syfluqs/farmbot/CAD/Render/stepper_motor_render.JPG

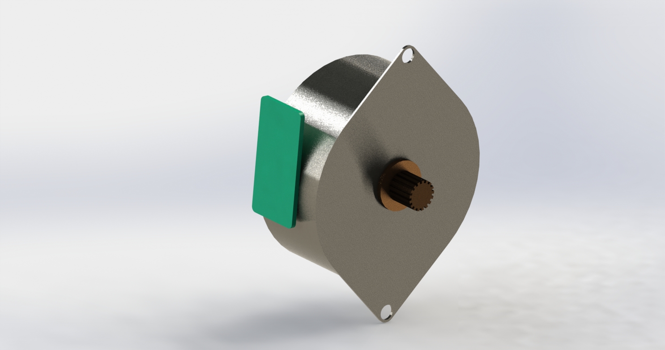
CAD/Render/stepper_motor_render.JPG
