syfluqs/farmbot/CAD/Render/carriage_motor_render_2.JPG

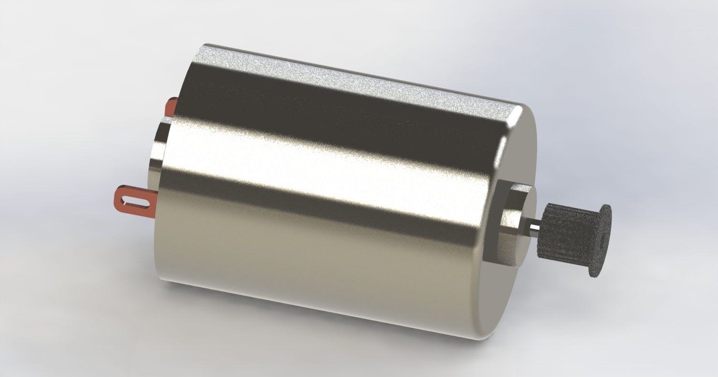
CAD/Render/carriage_motor_render_2.JPG
