syfluqs/farmbot/README.md

# farmbot
Firmware and code for 5th semester minor project

CAD model
<div class="sketchfab-embed-wrapper"><iframe width="640" height="480" src="https://sketchfab.com/models/de0491b01be34c9b8ab4bd9d8cf1a044/embed" frameborder="0" allowvr allowfullscreen mozallowfullscreen="true" webkitallowfullscreen="true" onmousewheel=""></iframe>

<p style="font-size: 13px; font-weight: normal; margin: 5px; color: #4A4A4A;">
    <a href="https://sketchfab.com/models/de0491b01be34c9b8ab4bd9d8cf1a044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" target="_blank" style="font-weight: bold; color: #1CAAD9;">Farmbot</a>
    by <a href="https://sketchfab.com/syfluqs?utm_medium=embed&utm_source=website&utm_campain=share-popup" target="_blank" style="font-weight: bold; color: #1CAAD9;">Subham Roy</a>
    on <a href="https://sketchfab.com?utm_medium=embed&utm_source=website&utm_campain=share-popup" target="_blank" style="font-weight: bold; color: #1CAAD9;">Sketchfab</a>
</p>
</div>

View the CAD model at http://sketchfab.com/models/de0491b01be34c9b8ab4bd9d8cf1a044 and components at https://grabcad.com/library/farmbot-1
