syfluqs/farmbot/CAD/Render/carriage_motor_render.JPG

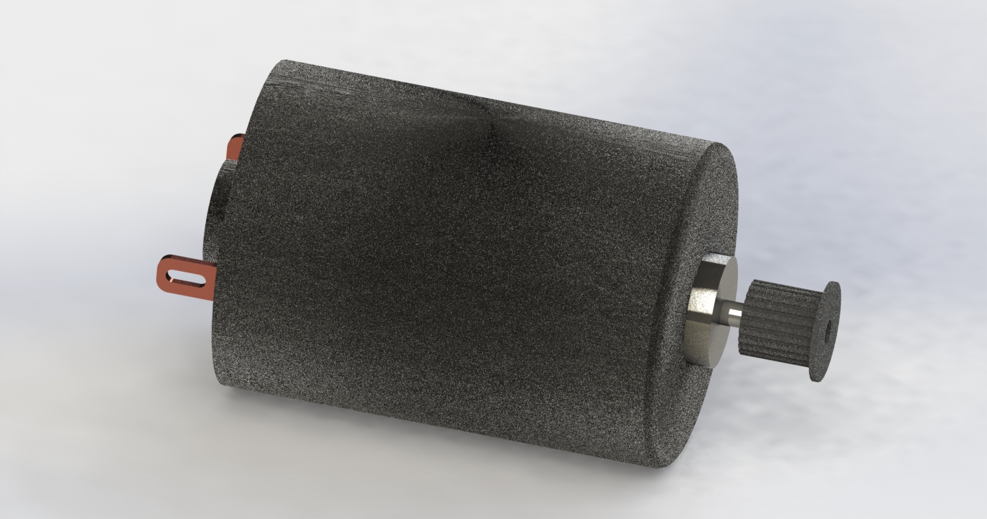
CAD/Render/carriage_motor_render.JPG
