syfluqs/farmbot/CAD/Render/johnson_motor_render.JPG

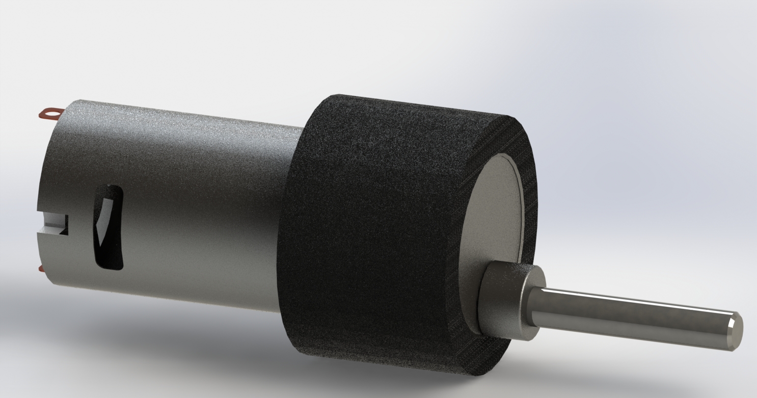
CAD/Render/johnson_motor_render.JPG
