syfluqs/farmbot/CAD/Render/rack_pinion_render_1.JPG

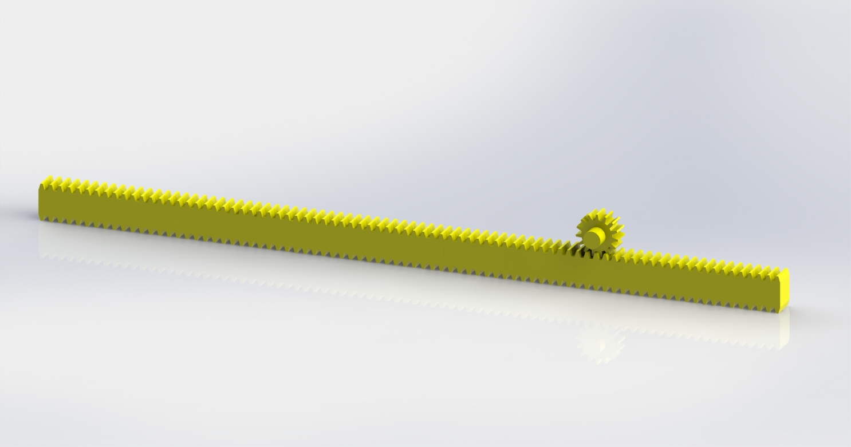
CAD/Render/rack_pinion_render_1.JPG
