syfluqs/farmbot/CAD/Render/rack_pinion_render_2.JPG

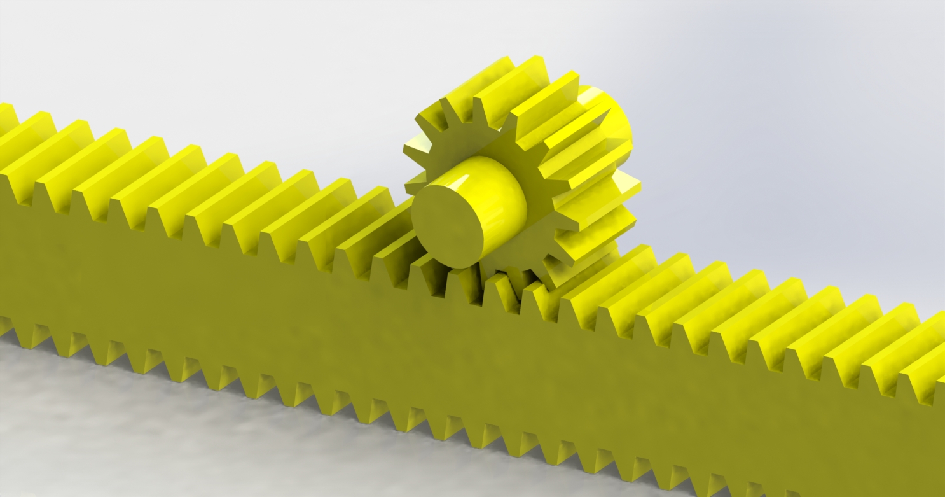
CAD/Render/rack_pinion_render_2.JPG
