syfluqs/farmbot/CAD/Render/rack_pinion_render_3.JPG

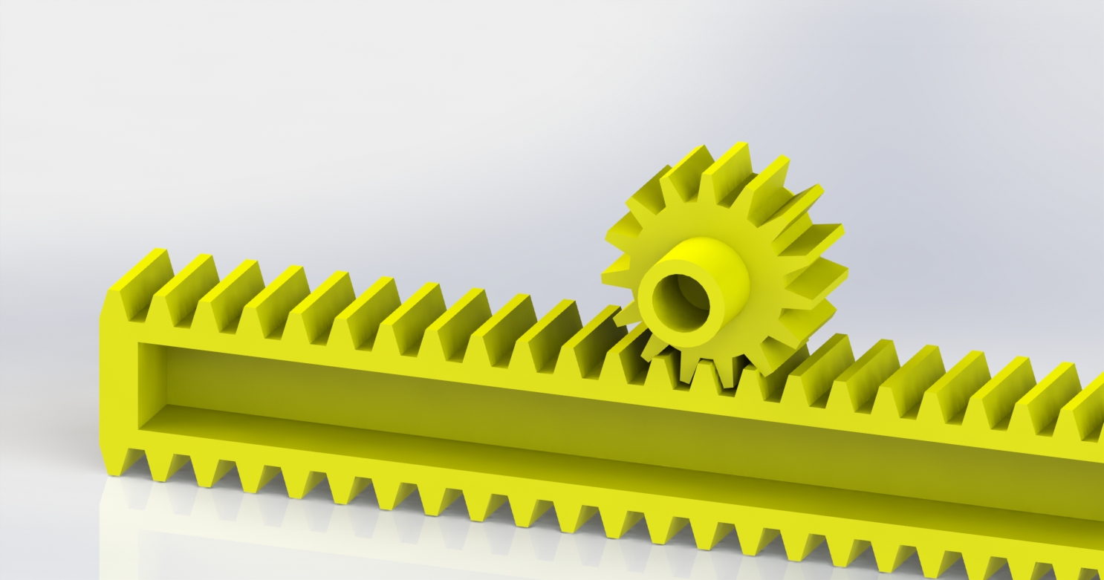
CAD/Render/rack_pinion_render_3.JPG
