syfluqs/farmbot/CAD/Render/wheel_rail_render.JPG

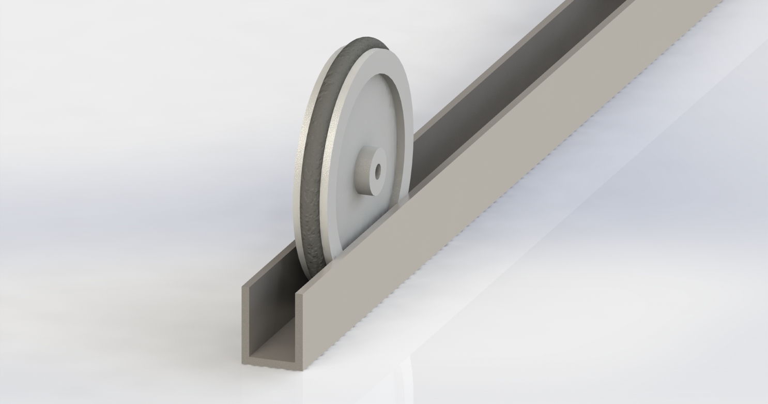
CAD/Render/wheel_rail_render.JPG
