syfluqs/farmbot/Circuit Diagram/Circuit_Diagram.png

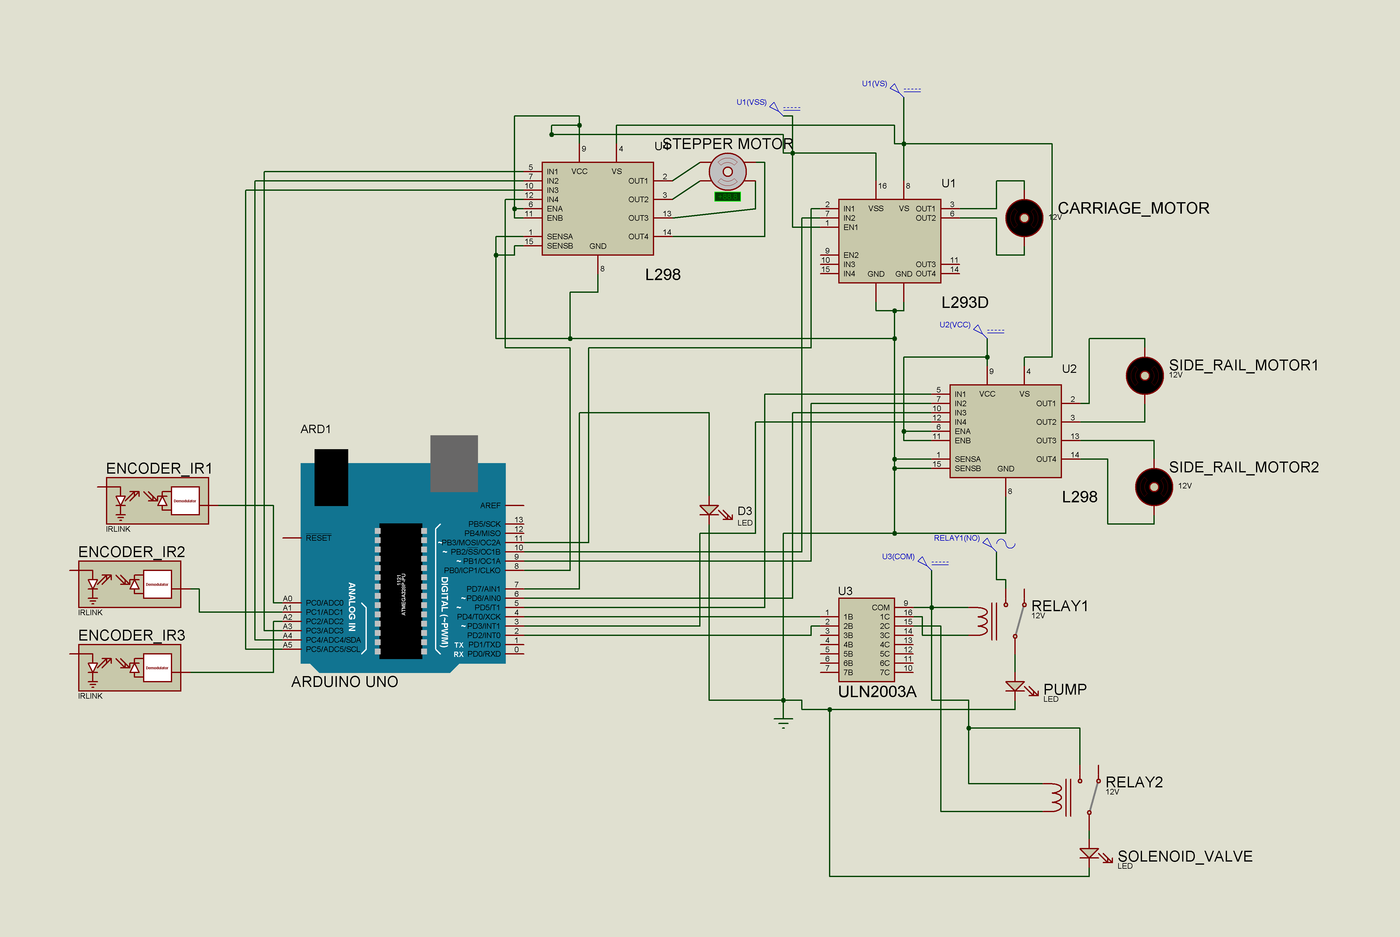
Circuit Diagram/Circuit_Diagram.png
