syfluqs/farmbot/CAD/final_assembly.SLDASM

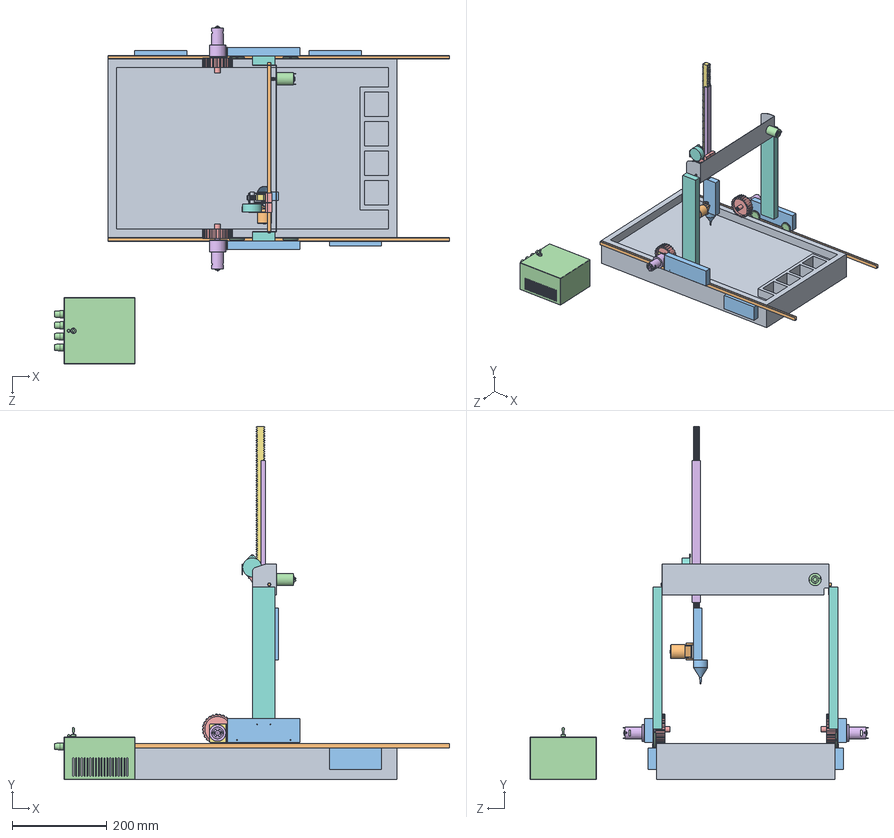
[picture p57: CAD file, 2016-11-20]
CAD/final_assembly.SLDASM
832.9 x 744.9 x 712.8 mm
soil_bed
rail x 2
connecting_plank x 2
pulley_wheel x 4
wheel_small x 2
motor_johnson x 2
clamp x 2
gantry_plank x 2
printer_bed_walls
lead_rod
supporting_block x 4
carriage_motor
printer_carriage
casing
rack
stepper
pinion
solenoid_valve
nozzle
psu
