syfluqs/farmbot/CAD/rack_pinion_assembly.SLDASM

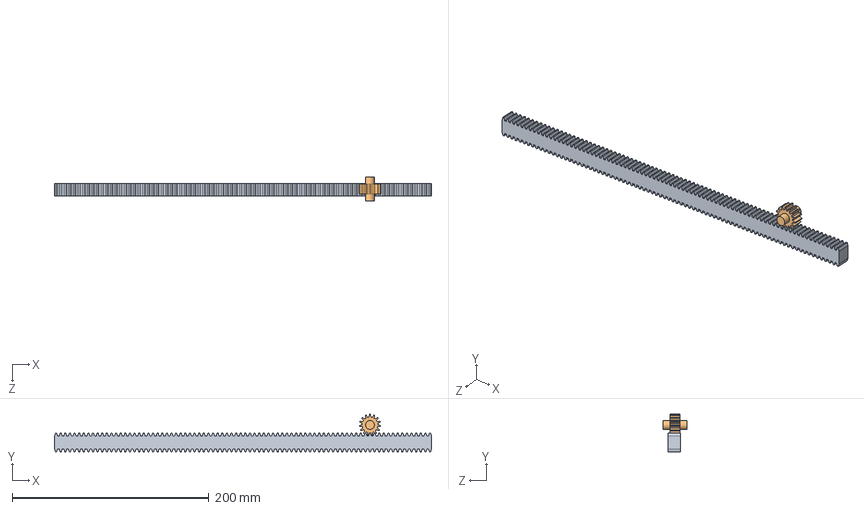
[picture p58: CAD file, 2016-11-20]
CAD/rack_pinion_assembly.SLDASM
383.0 x 38.2 x 24.0 mm
rack
pinion
