syfluqs/farmbot/CAD/Components/rail.SLDPRT

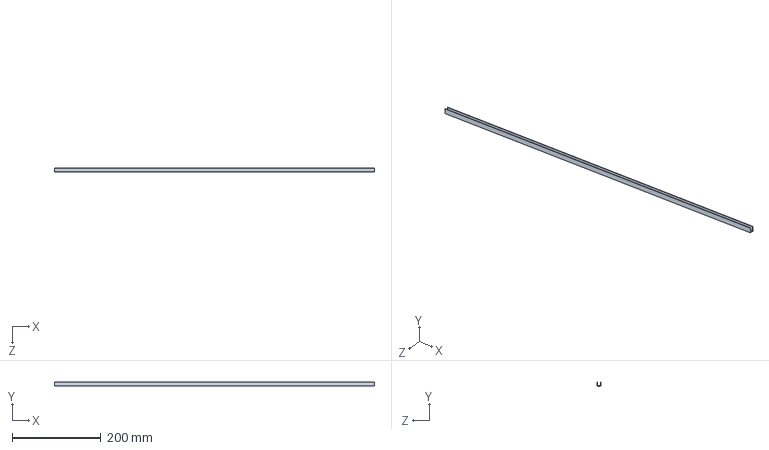
[picture p59: CAD file, 2016-11-20]
CAD/Components/rail.SLDPRT
720.0 x 10.0 x 8.00 mm
