syfluqs/farmbot/CAD/printer_carriage.SLDPRT

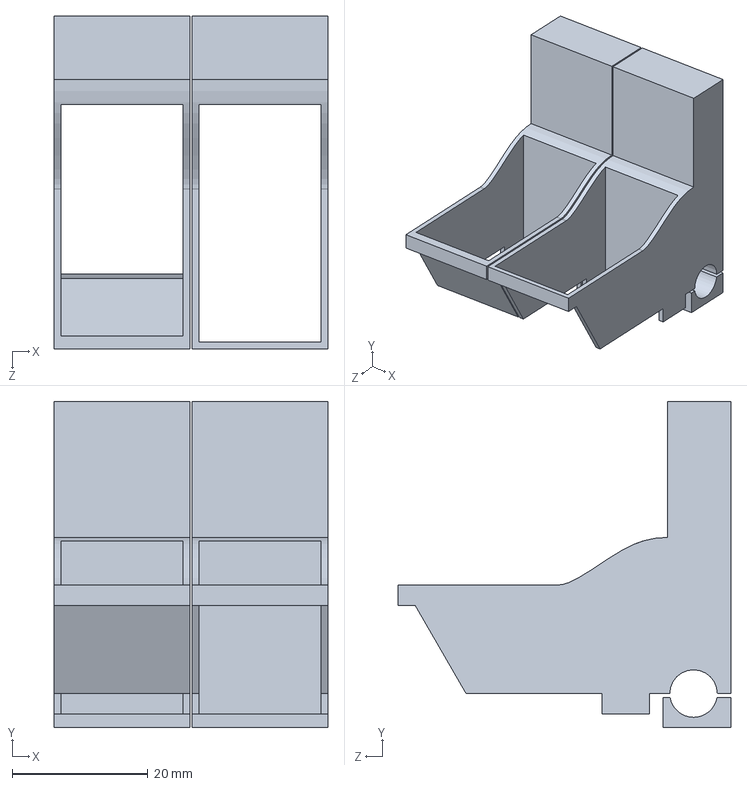
[picture p60: CAD file, 2016-11-20]
CAD/printer_carriage.SLDPRT
40.3 x 48.0 x 49.0 mm
