syfluqs/farmbot/CAD/Components/printer_bed_walls.SLDPRT

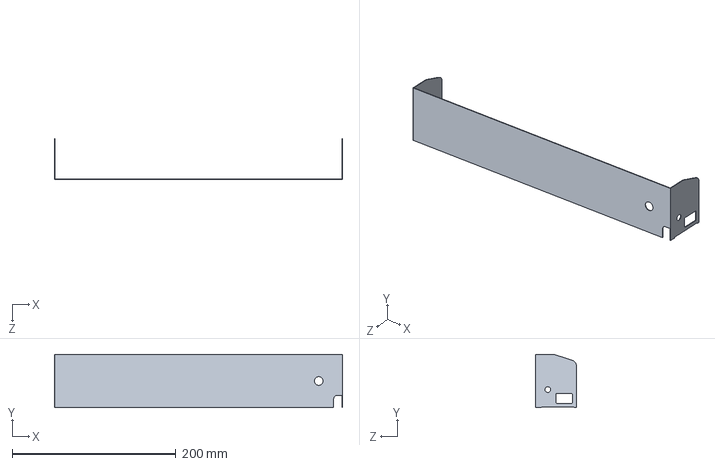
[picture p61: CAD file, 2016-11-18]
CAD/Components/printer_bed_walls.SLDPRT
351.4 x 65.0 x 50.0 mm
