syfluqs/farmbot/CAD/soil_bed.SLDPRT

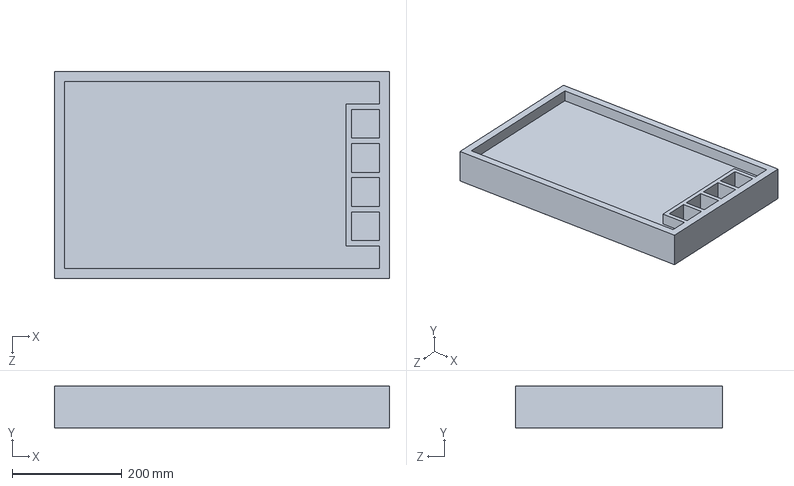
[picture p62: CAD file, 2016-11-20]
CAD/soil_bed.SLDPRT
609.6 x 76.2 x 376.4 mm
