syfluqs/farmbot/CAD/Components/gantry_plank.SLDPRT

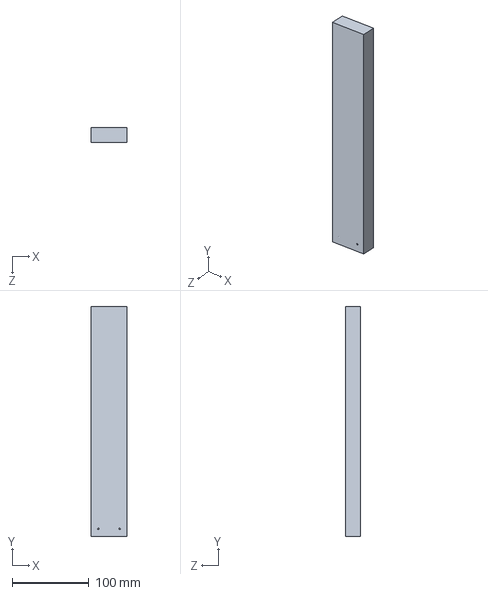
[picture p63: CAD file, 2016-11-18]
CAD/Components/gantry_plank.SLDPRT
47.0 x 300.0 x 19.0 mm
