syfluqs/farmbot/CAD/nozzle.SLDPRT

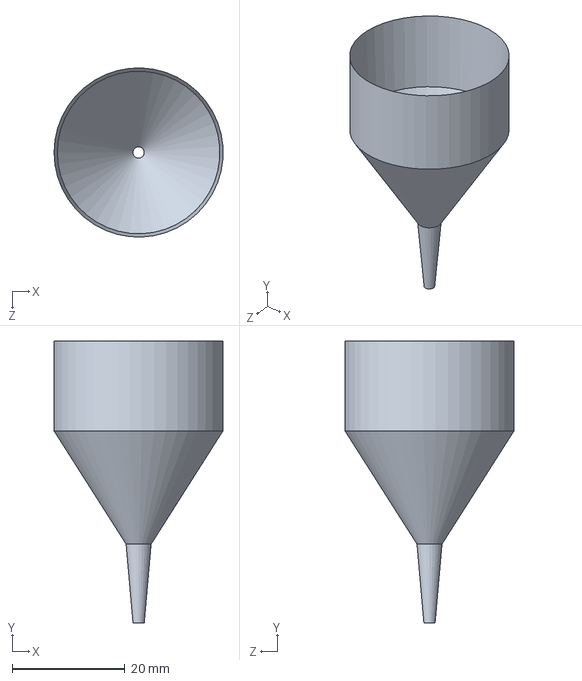
[picture p64: CAD file, 2016-11-20]
CAD/nozzle.SLDPRT
30.0 x 50.0 x 30.0 mm
