syfluqs/farmbot/CAD/casing.SLDPRT

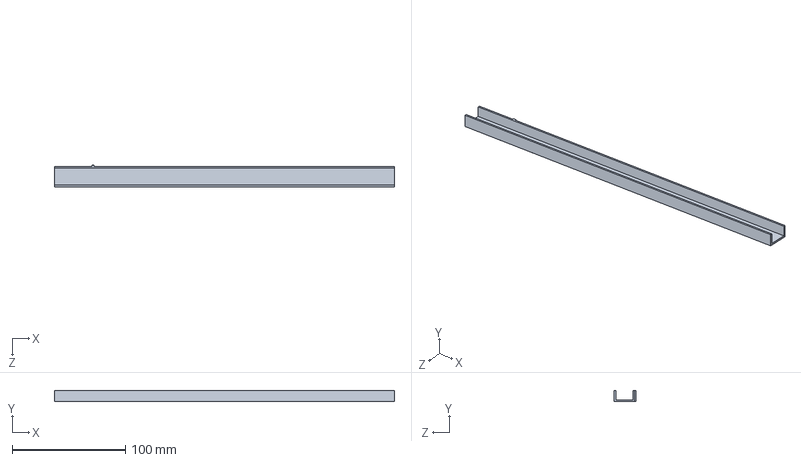
[picture p65: CAD file, 2016-11-20]
CAD/casing.SLDPRT
300.0 x 10.0 x 19.0 mm
