syfluqs/farmbot/CAD/Components/lead_rod.SLDPRT

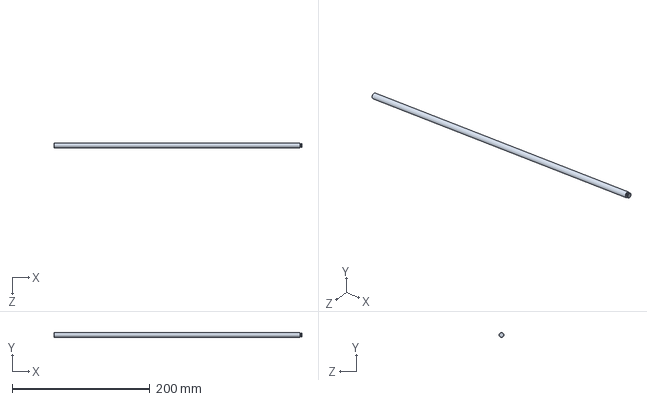
[picture p66: CAD file, 2016-11-15]
CAD/Components/lead_rod.SLDPRT
360.0 x 7.00 x 7.00 mm
