syfluqs/farmbot/CAD/wheel_small.SLDPRT

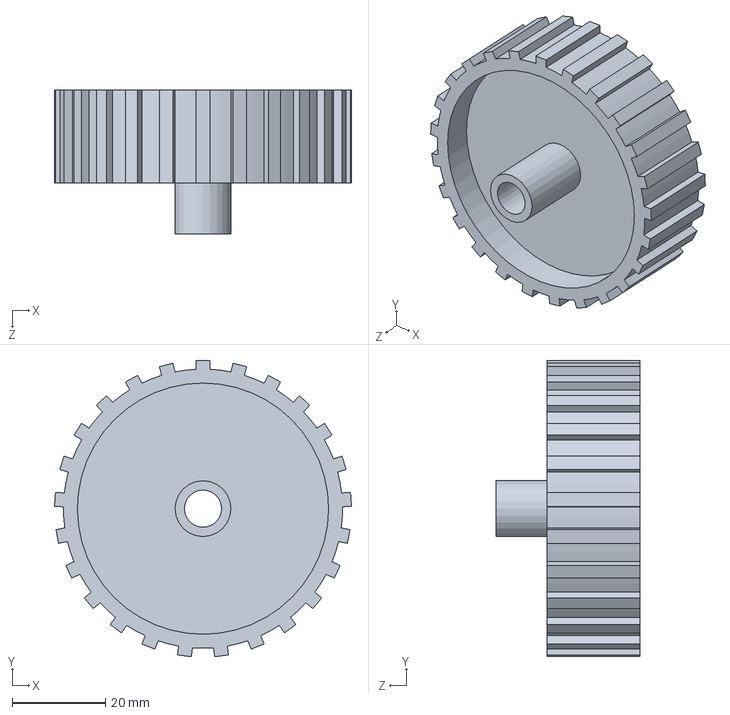
[picture p67: CAD file, 2016-11-20]
CAD/wheel_small.SLDPRT
63.8 x 63.7 x 31.0 mm
