syfluqs/farmbot/CAD/connecting_plank.SLDPRT

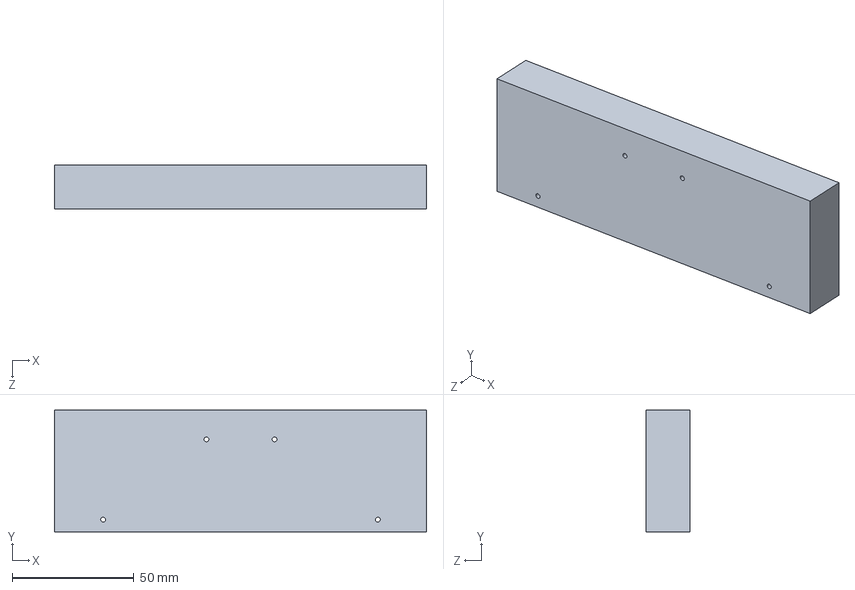
[picture p68: CAD file, 2016-11-20]
CAD/connecting_plank.SLDPRT
153.0 x 50.0 x 18.0 mm
