syfluqs/farmbot/CAD/rack.SLDPRT

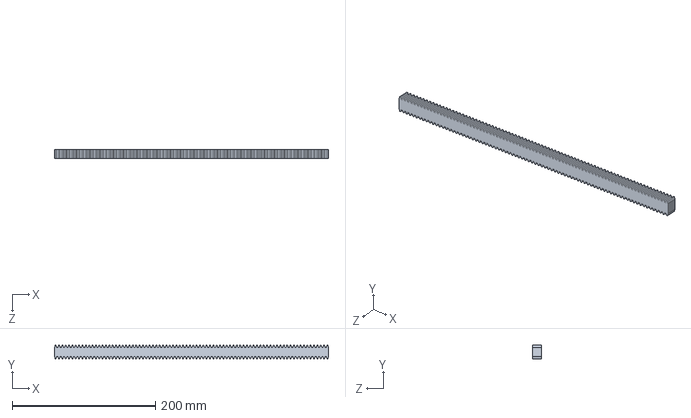
[picture p69: CAD file, 2016-11-20]
CAD/rack.SLDPRT
383.0 x 19.0 x 13.0 mm
