syfluqs/farmbot/CAD/pinion.SLDPRT

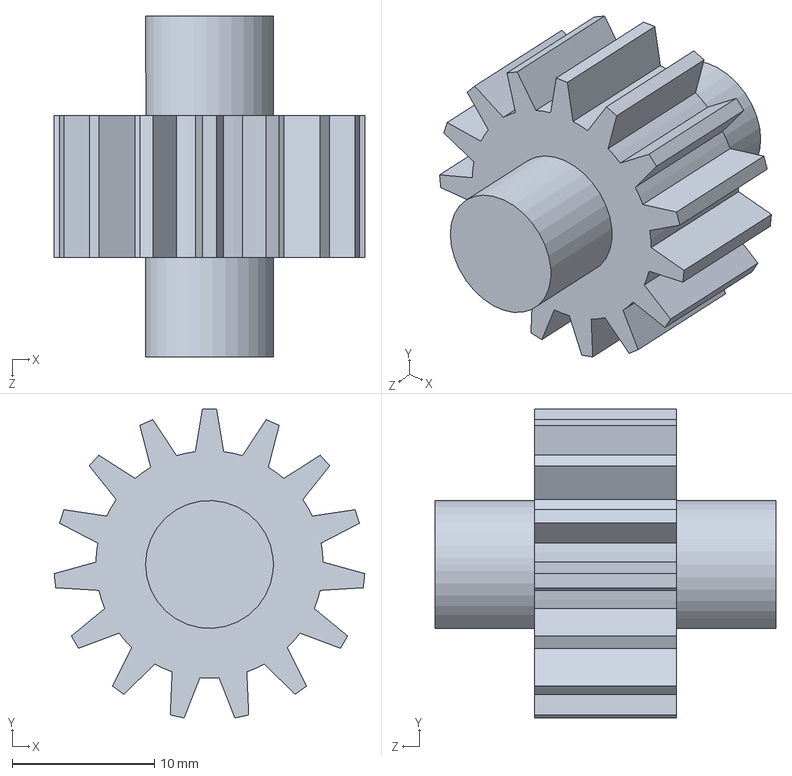
[picture p70: CAD file, 2016-11-20]
CAD/pinion.SLDPRT
21.9 x 21.7 x 24.0 mm
