syfluqs/farmbot/CAD/solenoid_valve.SLDPRT

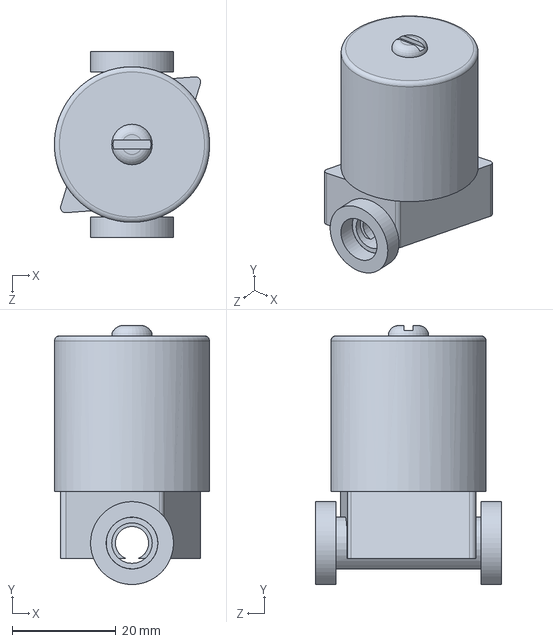
[picture p71: CAD file, 2016-11-20]
CAD/solenoid_valve.SLDPRT
30.0 x 50.0 x 36.0 mm
