syfluqs/farmbot/CAD/supporting_block.SLDPRT

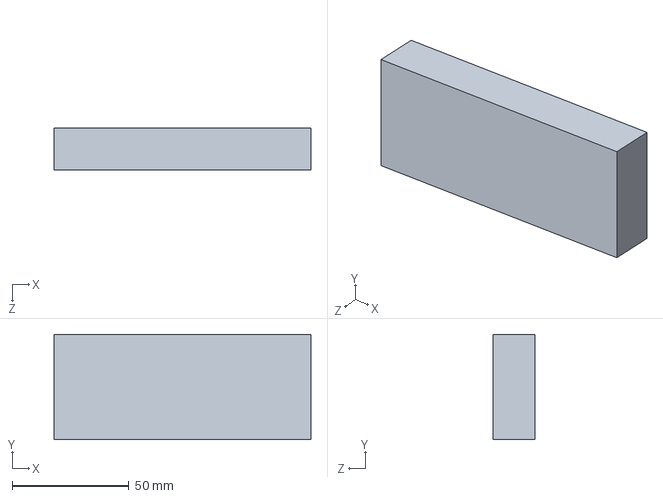
[picture p72: CAD file, 2016-11-20]
CAD/supporting_block.SLDPRT
110.0 x 45.0 x 18.0 mm
