syfluqs/farmbot/CAD/psu.SLDPRT

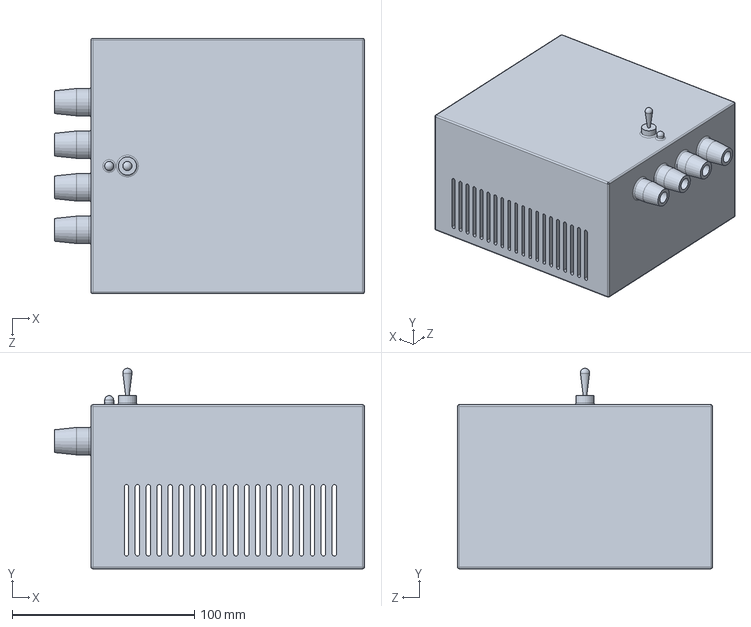
[picture p73: CAD file, 2016-11-20]
CAD/psu.SLDPRT
170.0 x 110.0 x 140.0 mm
