syfluqs/farmbot/CAD/arduino nano.SLDPRT

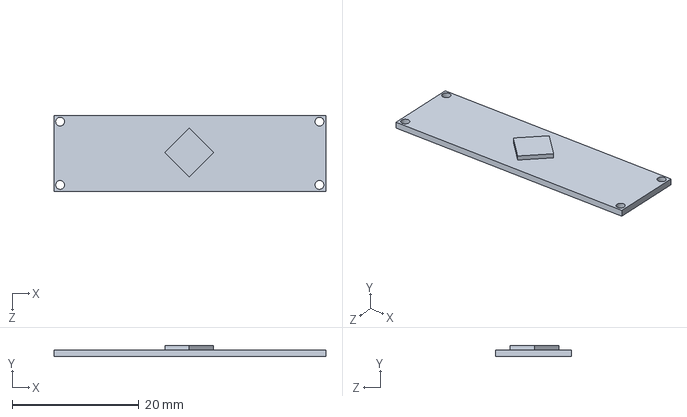
[picture p74: CAD file, 2016-11-18]
CAD/arduino nano.SLDPRT
43.0 x 1.70 x 12.0 mm
