syfluqs/farmbot/CAD/clamp.SLDPRT

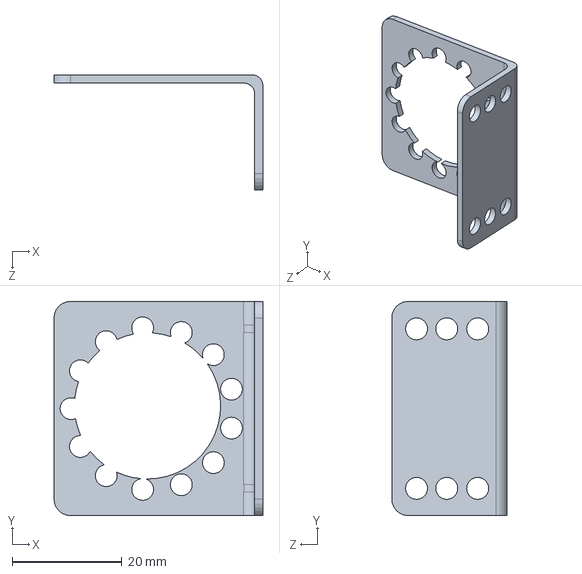
[picture p75: CAD file, 2016-11-18]
CAD/clamp.SLDPRT
38.0 x 39.0 x 21.0 mm
