syfluqs/farmbot/CAD/pulley_wheel.SLDPRT

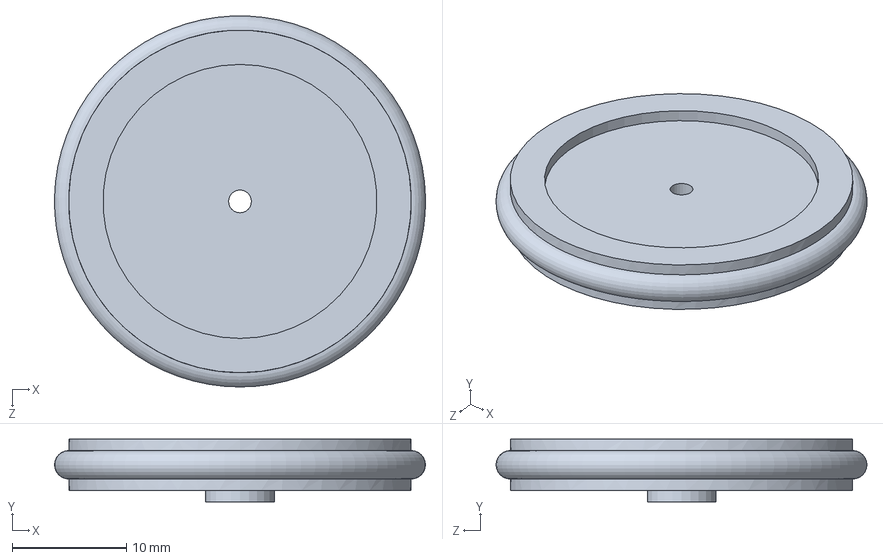
[picture p76: CAD file, 2016-11-18]
CAD/pulley_wheel.SLDPRT
32.5 x 5.50 x 32.5 mm
