syfluqs/farmbot/CAD/stepper.SLDPRT

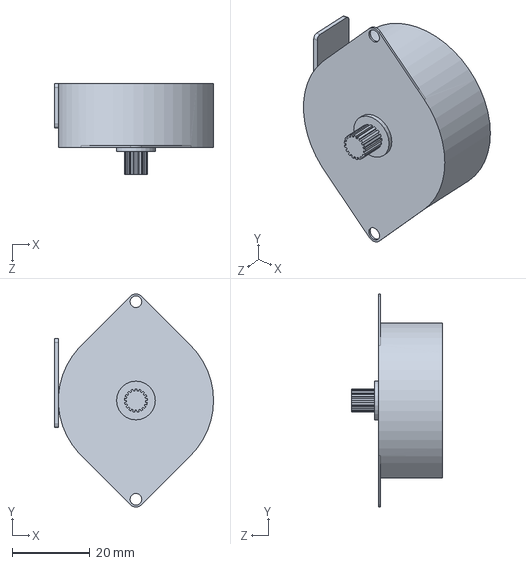
[picture p77: CAD file, 2016-11-18]
CAD/stepper.SLDPRT
41.0 x 54.9 x 23.5 mm
