syfluqs/farmbot/CAD/motor_johnson.SLDPRT

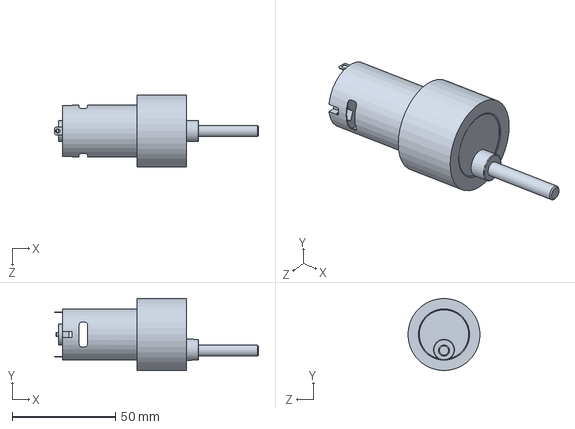
[picture p78: CAD file, 2016-11-18]
CAD/motor_johnson.SLDPRT
99.0 x 35.0 x 35.0 mm
