syfluqs/farmbot/CAD/raspberry_pi.SLDPRT

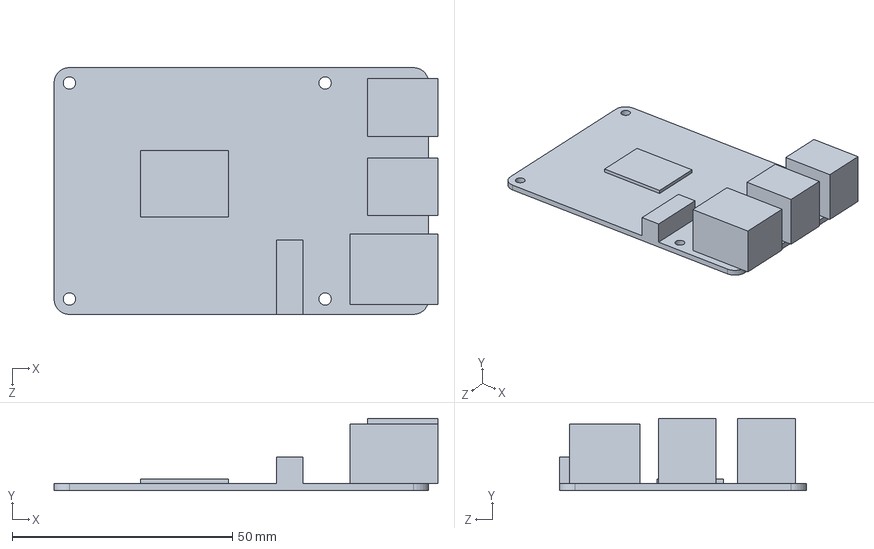
[picture p79: CAD file, 2016-11-18]
CAD/raspberry_pi.SLDPRT
87.1 x 16.4 x 56.0 mm
