syfluqs/farmbot/CAD/carriage_motor.SLDPRT

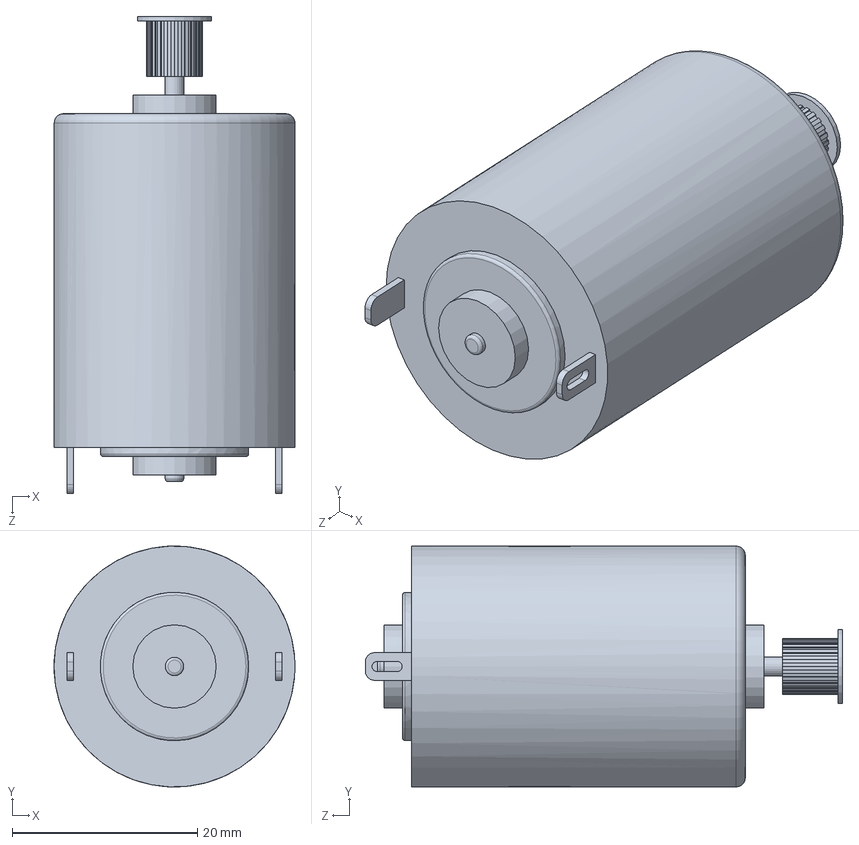
[picture p80: CAD file, 2016-11-18]
CAD/carriage_motor.SLDPRT
26.0 x 26.0 x 51.5 mm
