syfluqs/farmbot/CAD/wheel.SLDPRT

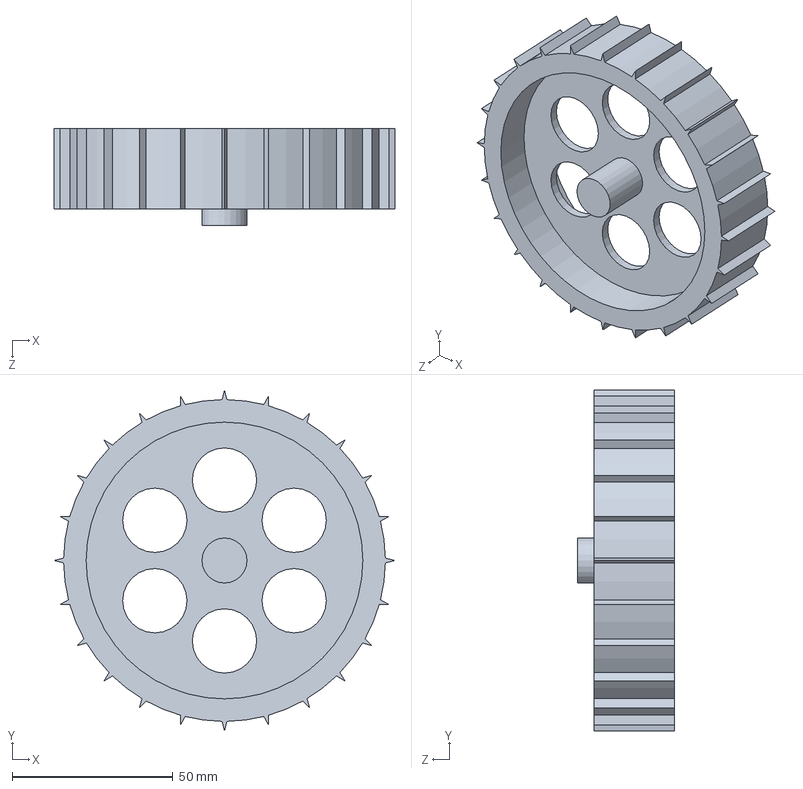
[picture p81: CAD file, 2016-11-18]
CAD/wheel.SLDPRT
106.0 x 106.0 x 30.0 mm
