syfluqs/farmbot/(list of files, drawings)

Other design files:
Circuit Diagram/Proteus/farmbot_circuit.pdsprj
