syfluqs/farmbot/(commit log)

2016-10-28 printer bed
    [lead_rod.SLDPRT, printer_bed_walls.SLDPRT]
2016-10-28 printer bed assembly
    [printer_bed_assembly.SLDASM]
2016-10-28 modified printer_bed_walls profile
    [lead_rod.SLDPRT, printer_bed_assembly.SLDASM, printer_bed_walls.SLDPRT]
2016-10-28 new assembly, made printer head
    [printer_bed_assembly.SLDASM, printer_bed_walls.SLDPRT, printer_carriage_half.SLDPRT, printer_head.SLDASM]
2016-10-29 final assembly and tweaks
    [connecting_plank.SLDPRT, drawer_mechanism.SLDPRT, final_assembly.SLDASM, gantry_plank.SLDPRT, lead_rod.SLDPRT, printer_bed_assembly.SLDASM, printer_bed_walls.SLDPRT, printer_carriage.SLDPRT]
2016-11-17 Circuit Diagrams added
    [farmbot_circuit.pdsprj]
2016-11-20 some modifications
    [pinion.SLDPRT, printer_carriage.SLDPRT, psu.SLDPRT, rack.SLDPRT, rack_pinion_assembly.SLDASM, rail.SLDPRT, solenoid_valve.SLDPRT, supporting_block.SLDPRT]
2017-04-22 README.md embed CAD model
